SebastianPedroza04/Telemetria-Kart/telemetria-kart/docs/figuras/fig_dinamica.png

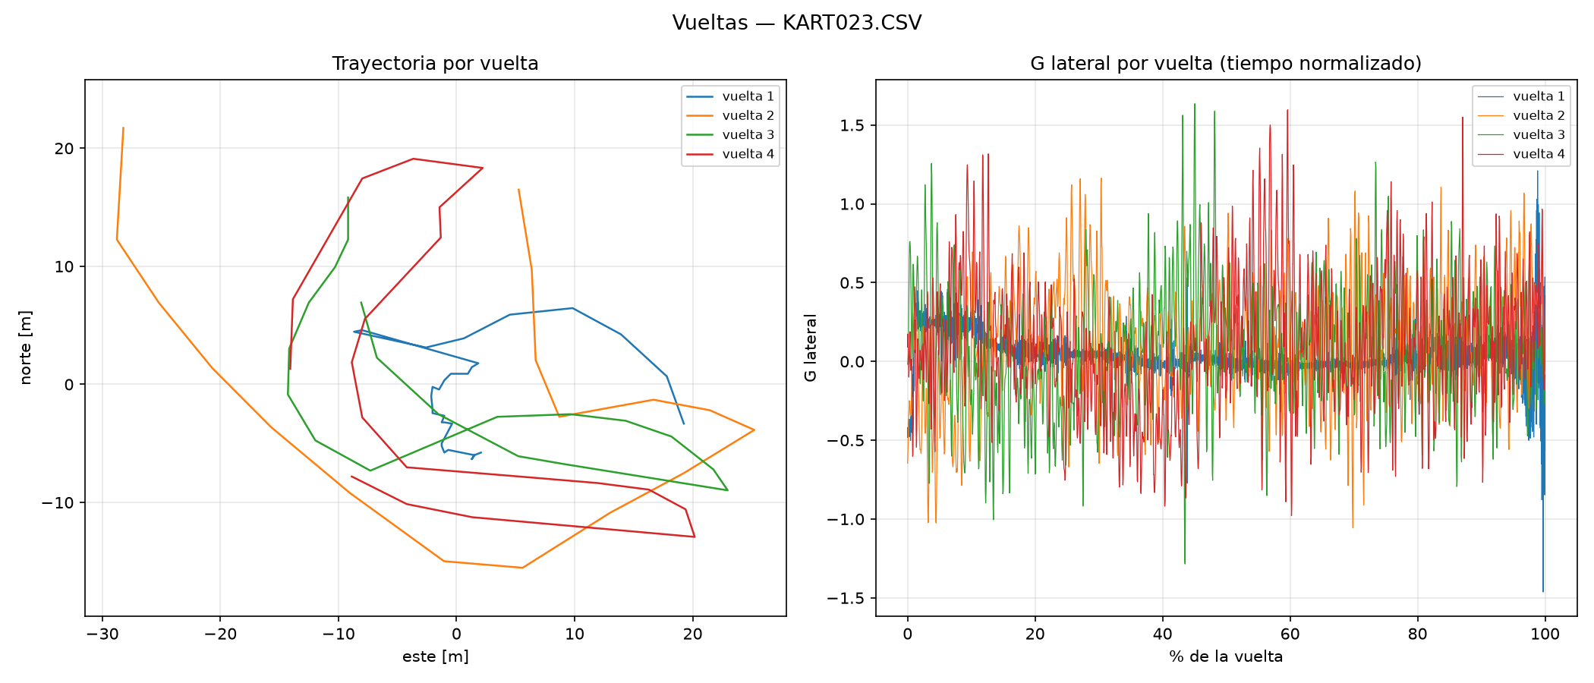
telemetria-kart/docs/figuras/fig_dinamica.png
