SebastianPedroza04/Telemetria-Kart/telemetria-kart/docs/figuras/fig_gg.png

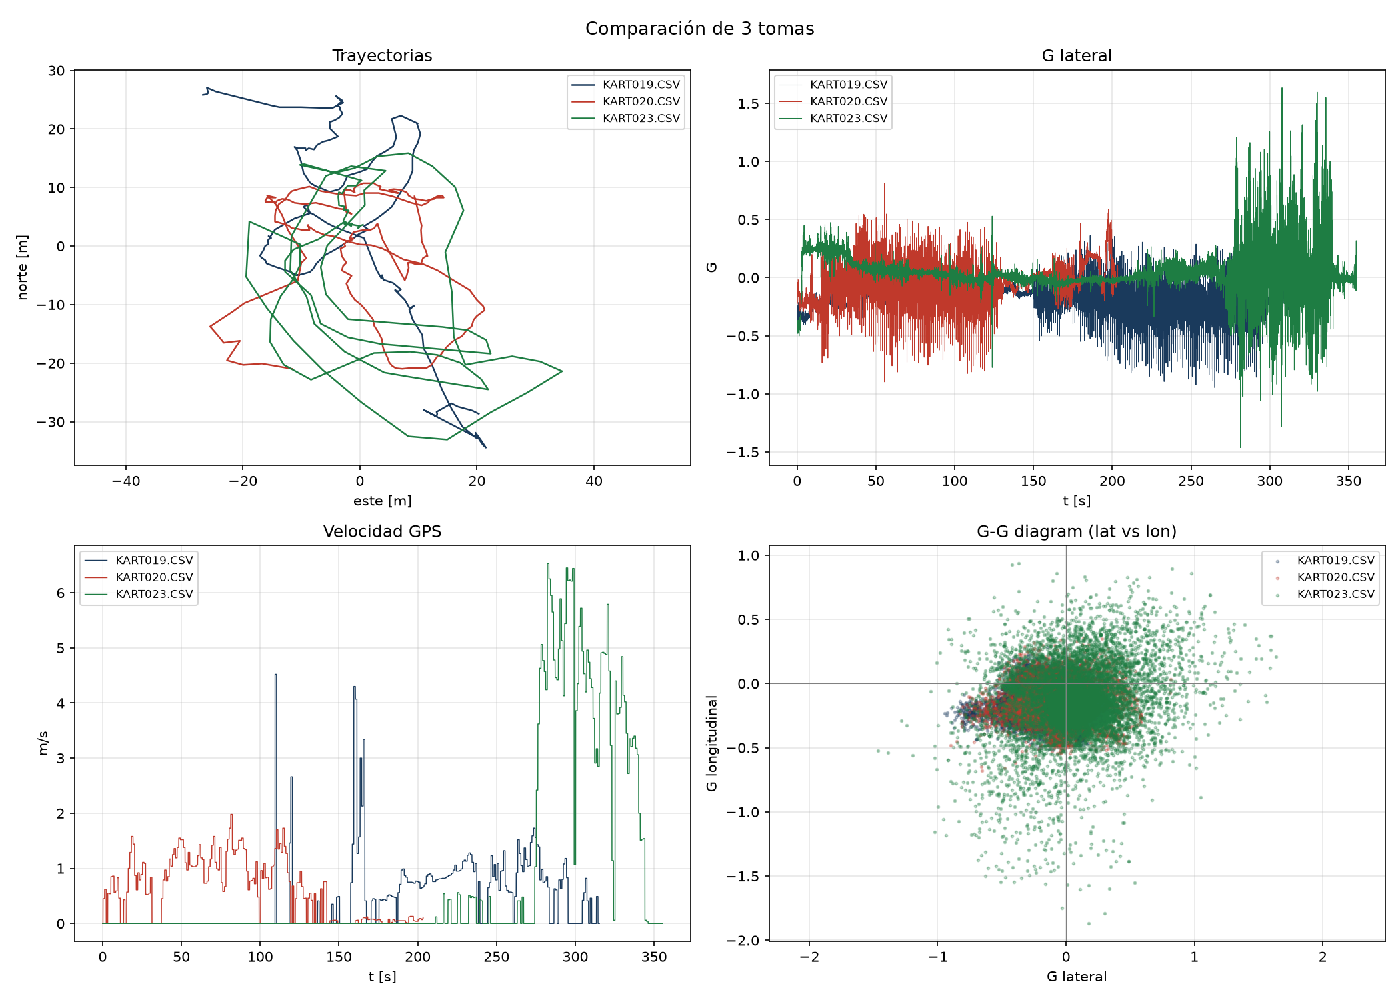
telemetria-kart/docs/figuras/fig_gg.png
