SebastianPedroza04/Telemetria-Kart/telemetria-kart/docs/figuras/fig_sd_lora.png

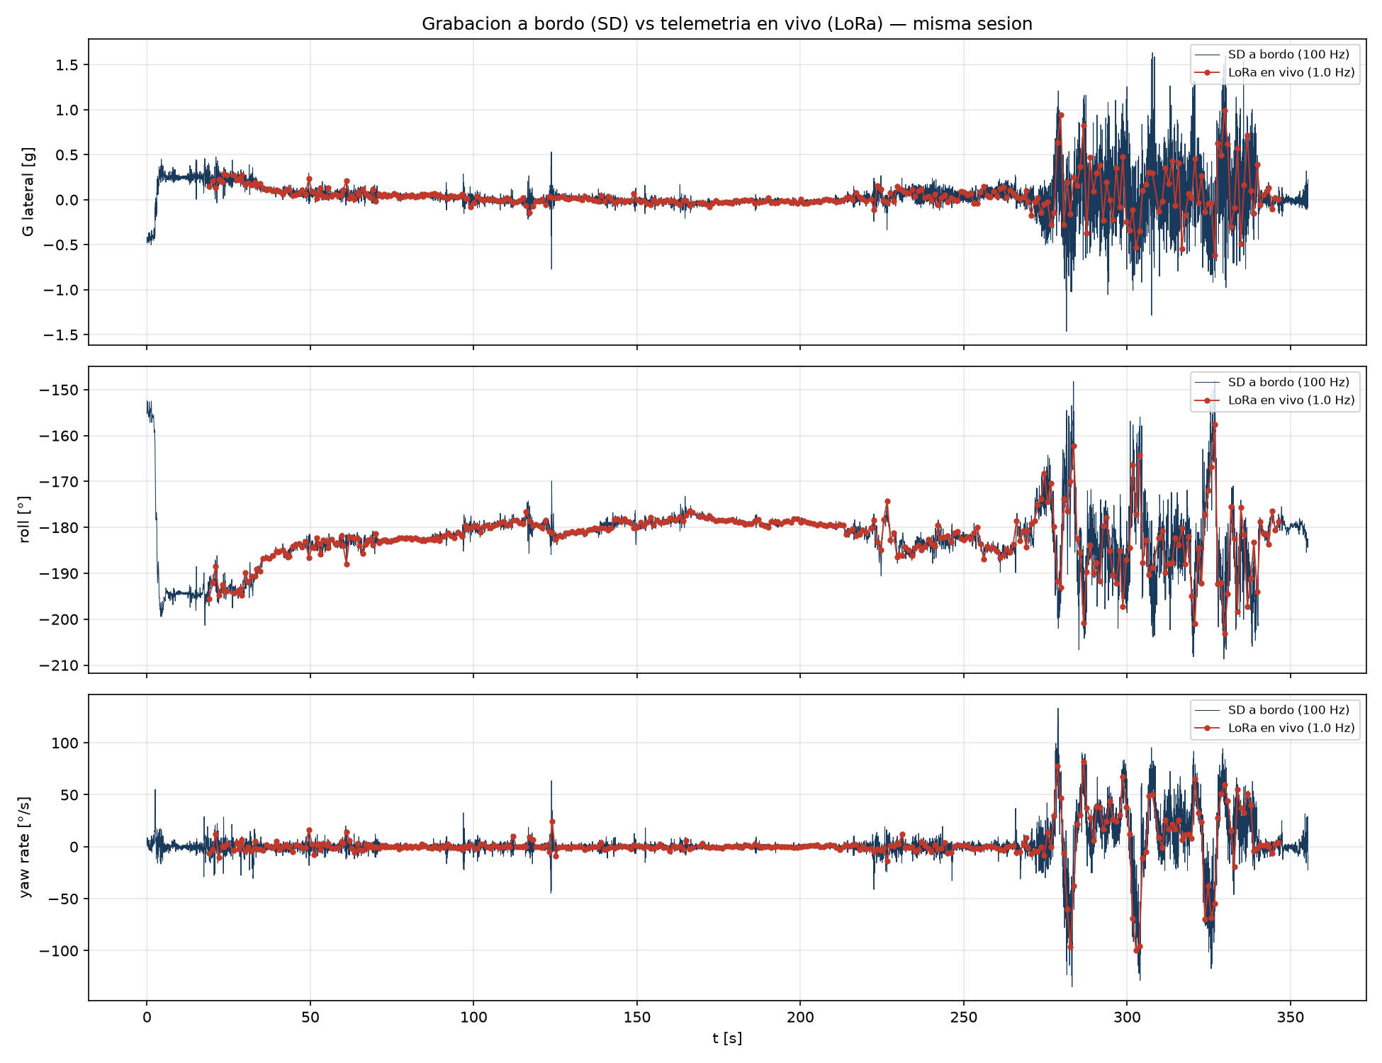
telemetria-kart/docs/figuras/fig_sd_lora.png
