SebastianPedroza04/Telemetria-Kart/telemetria-kart/docs/figuras/fig_trayectoria.png

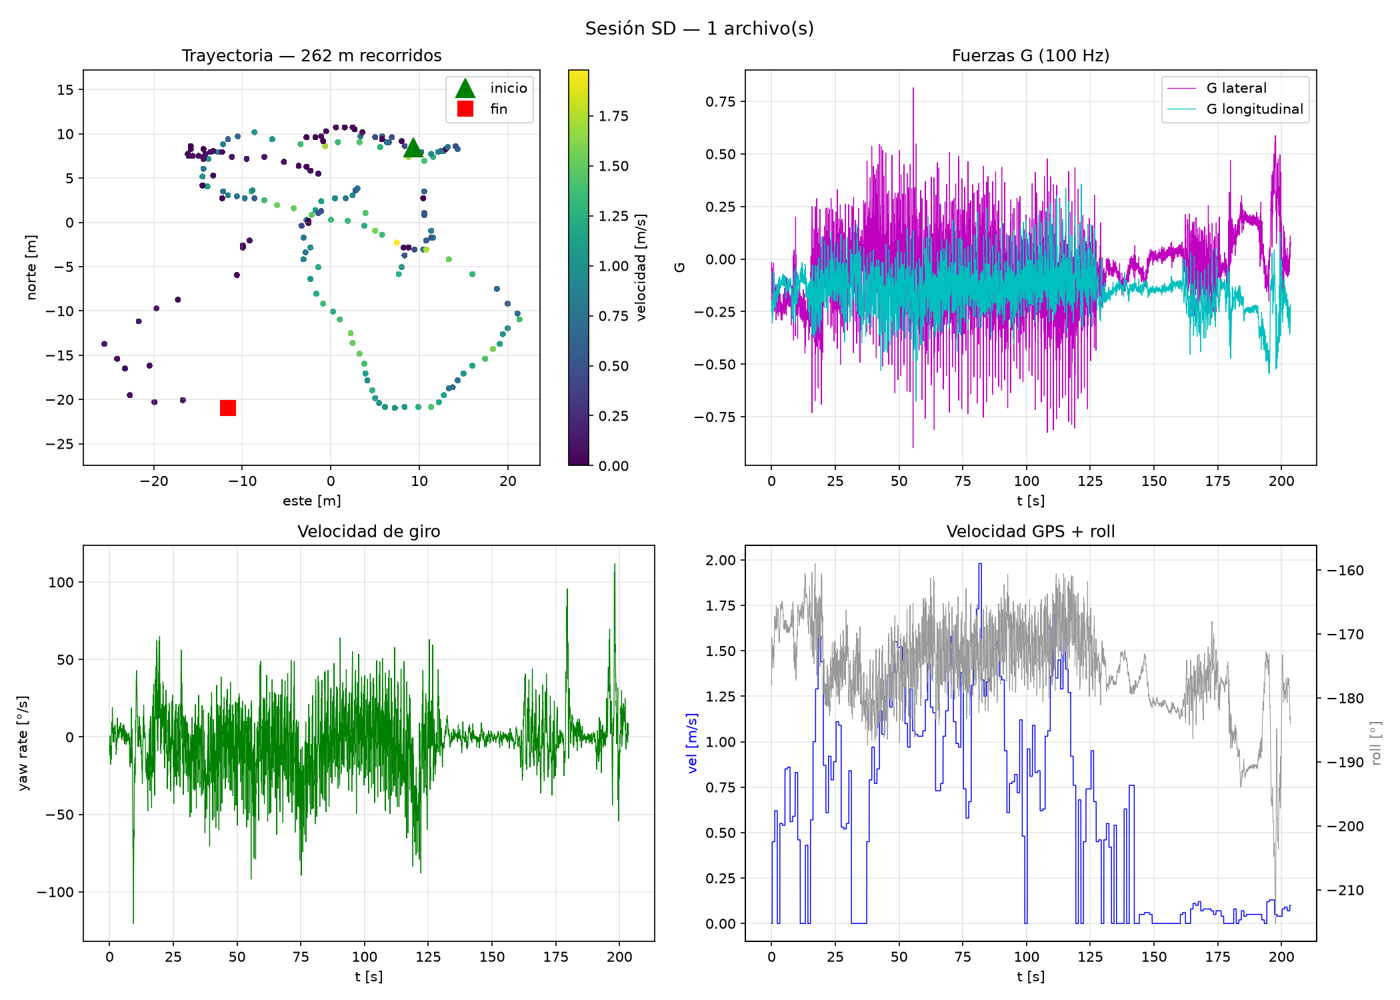
telemetria-kart/docs/figuras/fig_trayectoria.png
