SebastianPedroza04/Telemetria-Kart/telemetria-kart/docs/figuras/KART019_sesion.png

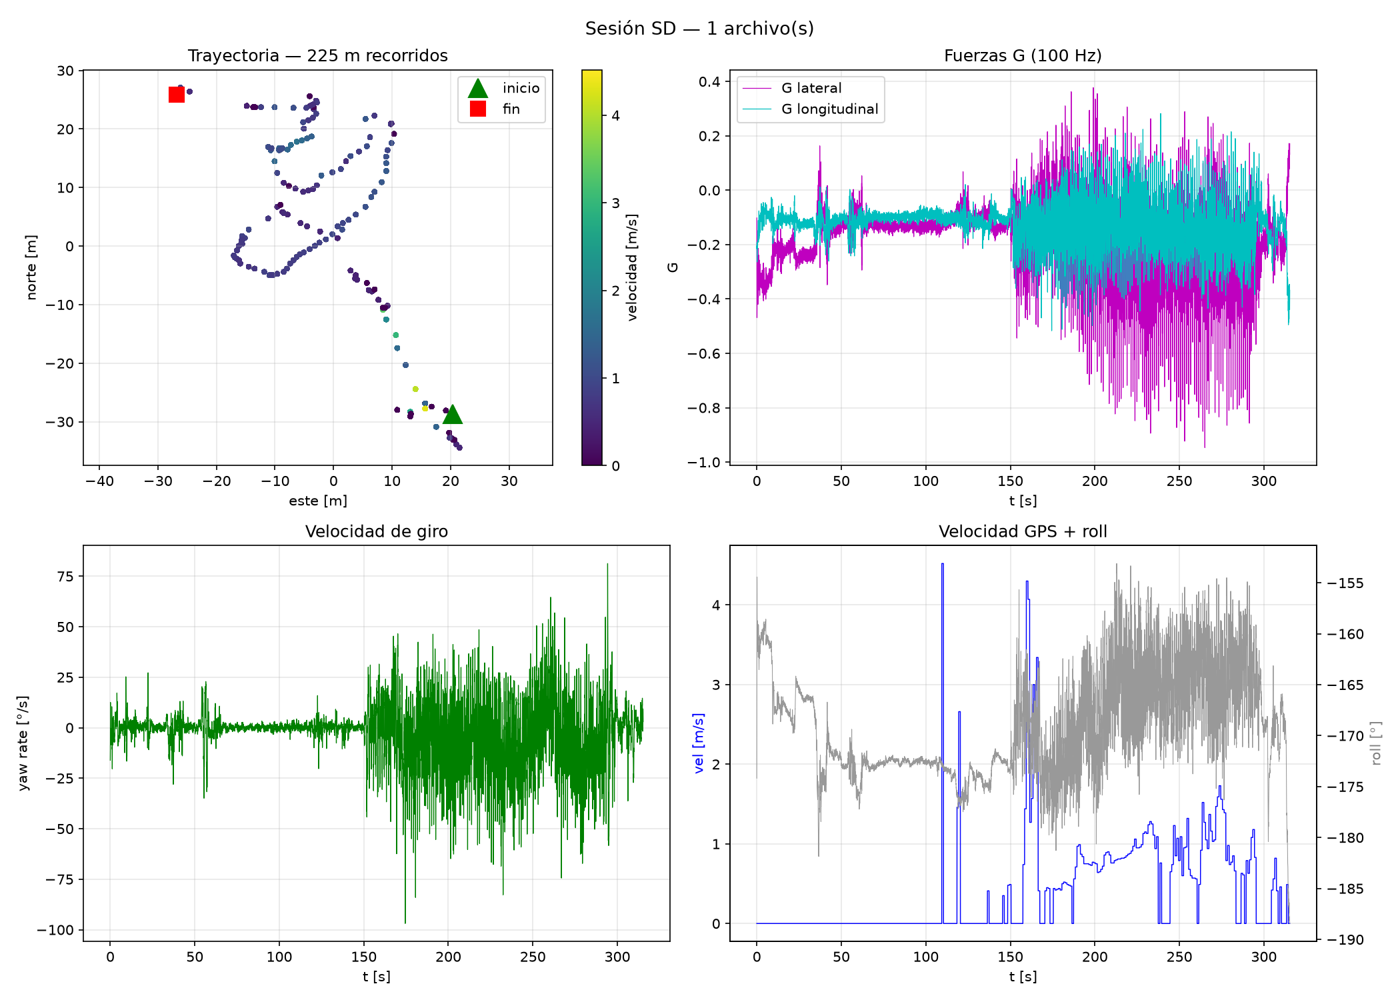
telemetria-kart/docs/figuras/KART019_sesion.png
