SebastianPedroza04/Telemetria-Kart/telemetria-kart/docs/figuras/KART023_sesion.png

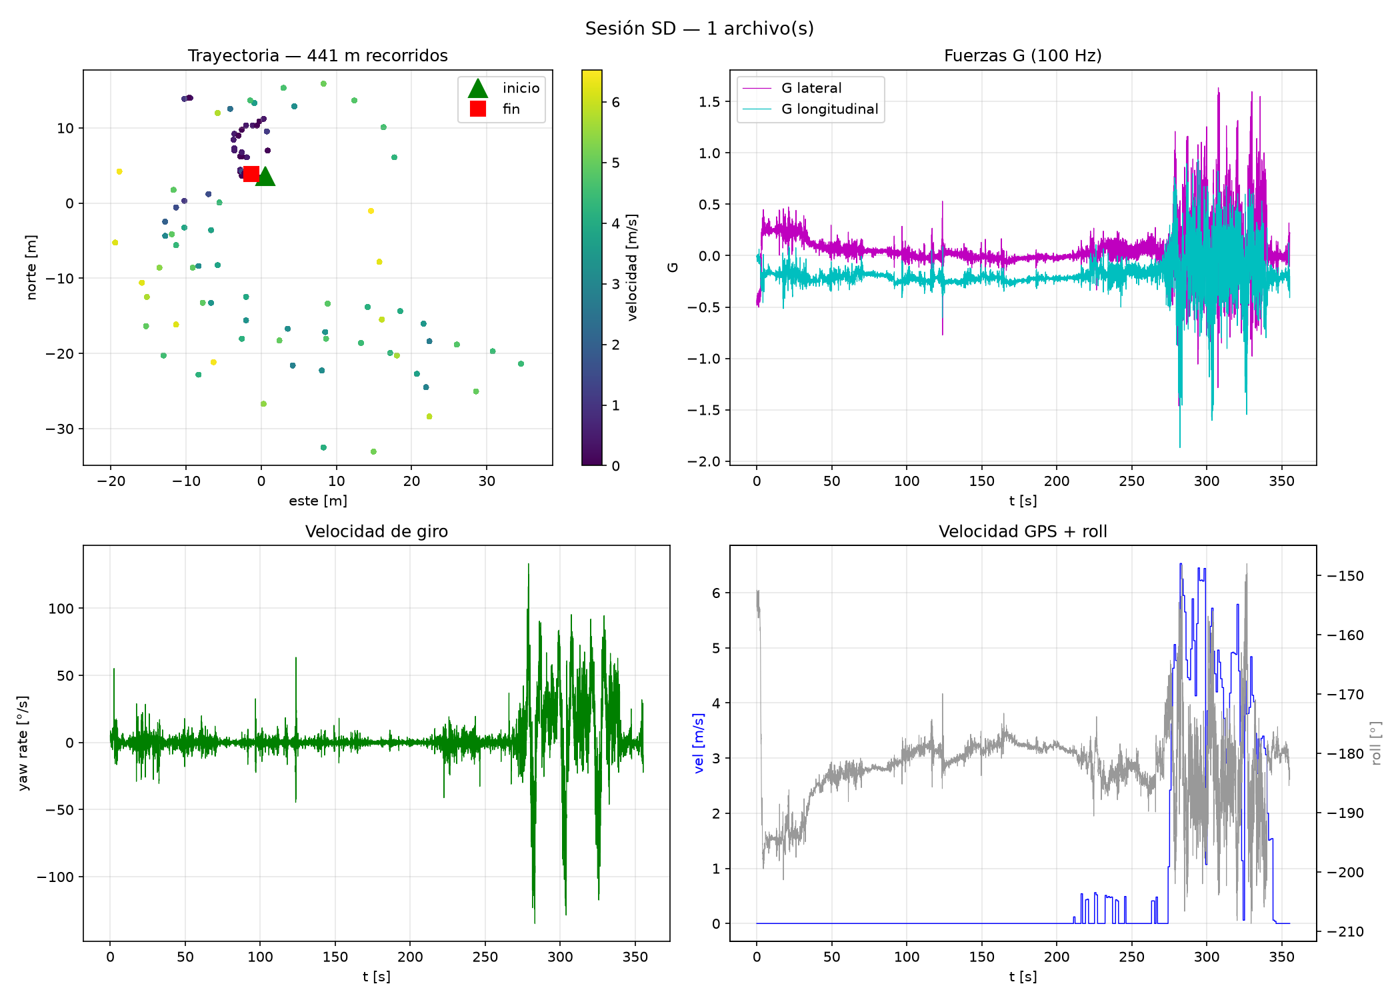
telemetria-kart/docs/figuras/KART023_sesion.png
