SebastianPedroza04/Telemetria-Kart/telemetria-kart/docs/informe/fig_arquitectura.png

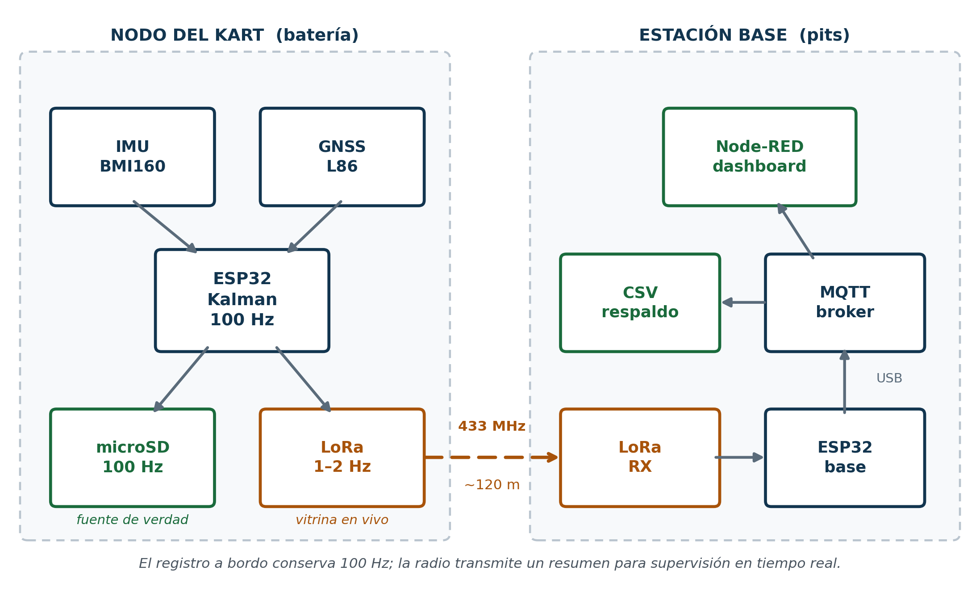
telemetria-kart/docs/informe/fig_arquitectura.png
