SebastianPedroza04/Telemetria-Kart/telemetria-kart/kart_avance_IBM_Loras_GPS/kart/data/deriva_20260717_031146_deriva.png

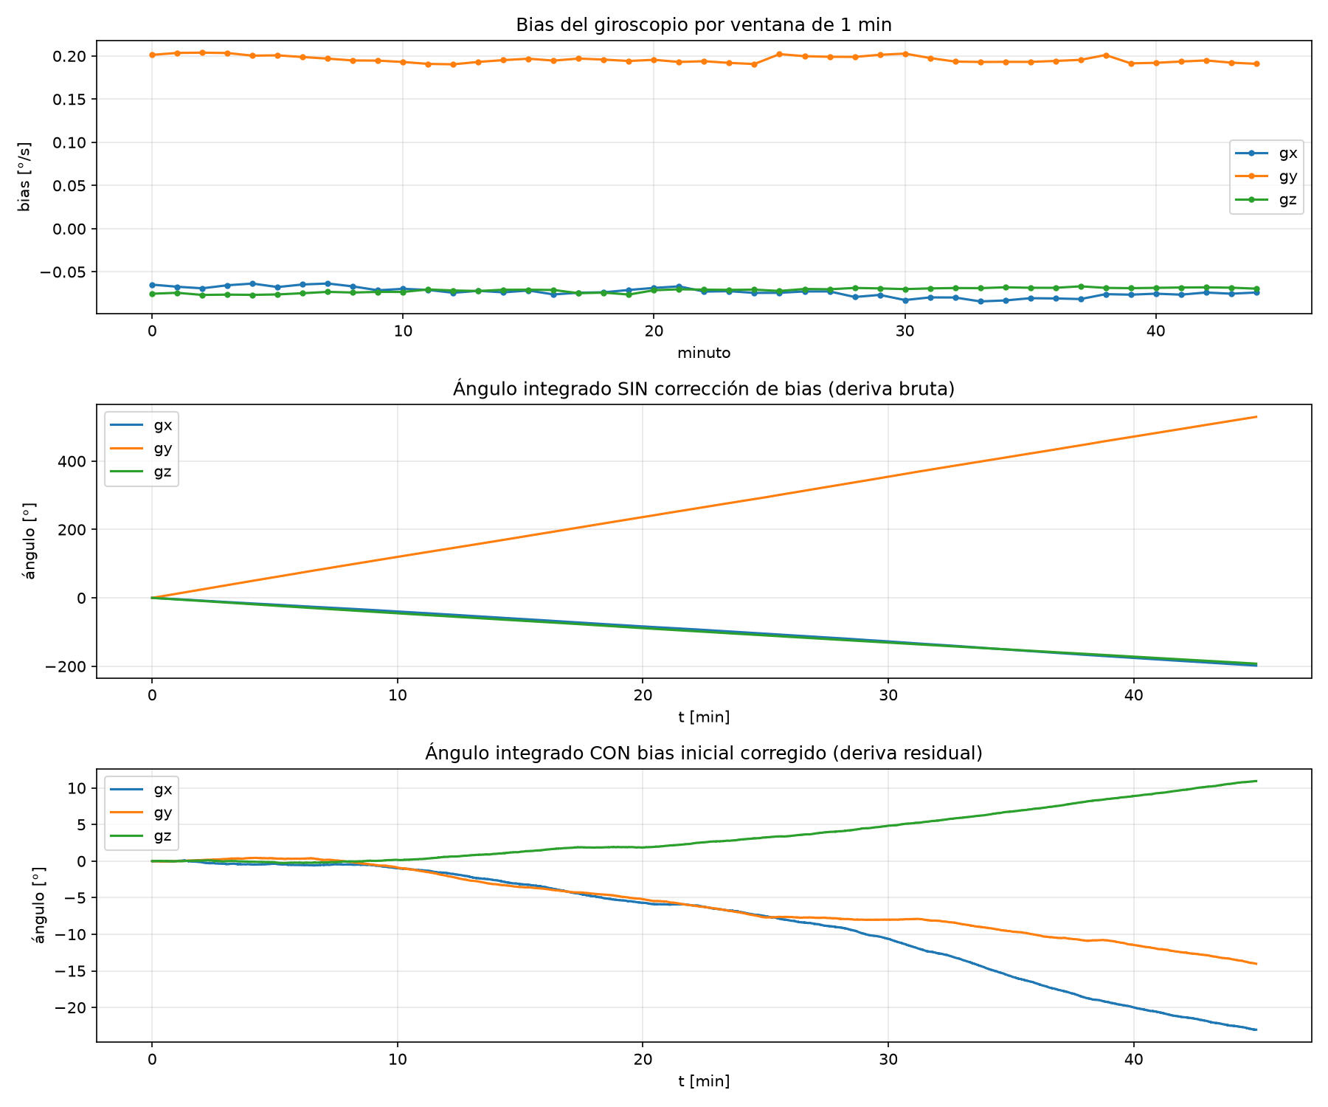
telemetria-kart/kart_avance_IBM_Loras_GPS/kart/data/deriva_20260717_031146_deriva.png
