SebastianPedroza04/Telemetria-Kart/telemetria-kart/kart_avance_IBM_Loras_GPS/kart/data/gps_caminata_20260722_132950_trazada.png

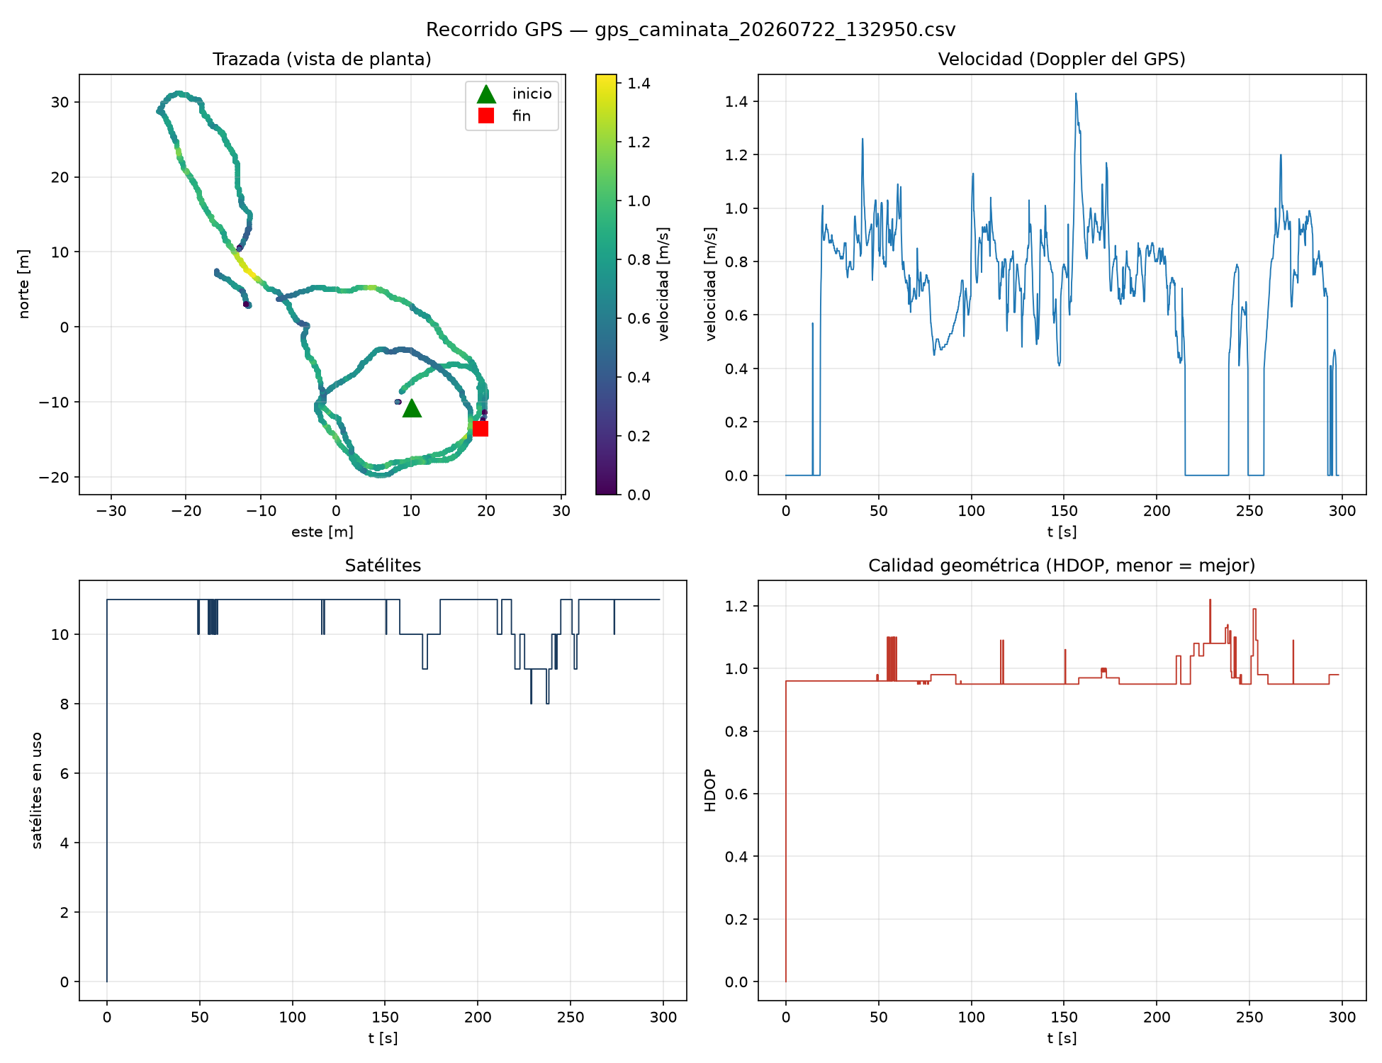
telemetria-kart/kart_avance_IBM_Loras_GPS/kart/data/gps_caminata_20260722_132950_trazada.png
