SebastianPedroza04/Telemetria-Kart/telemetria-kart/kart_avance_IBM_Loras_GPS/kart/data/kfv3_20260717_121305_comparacion.png

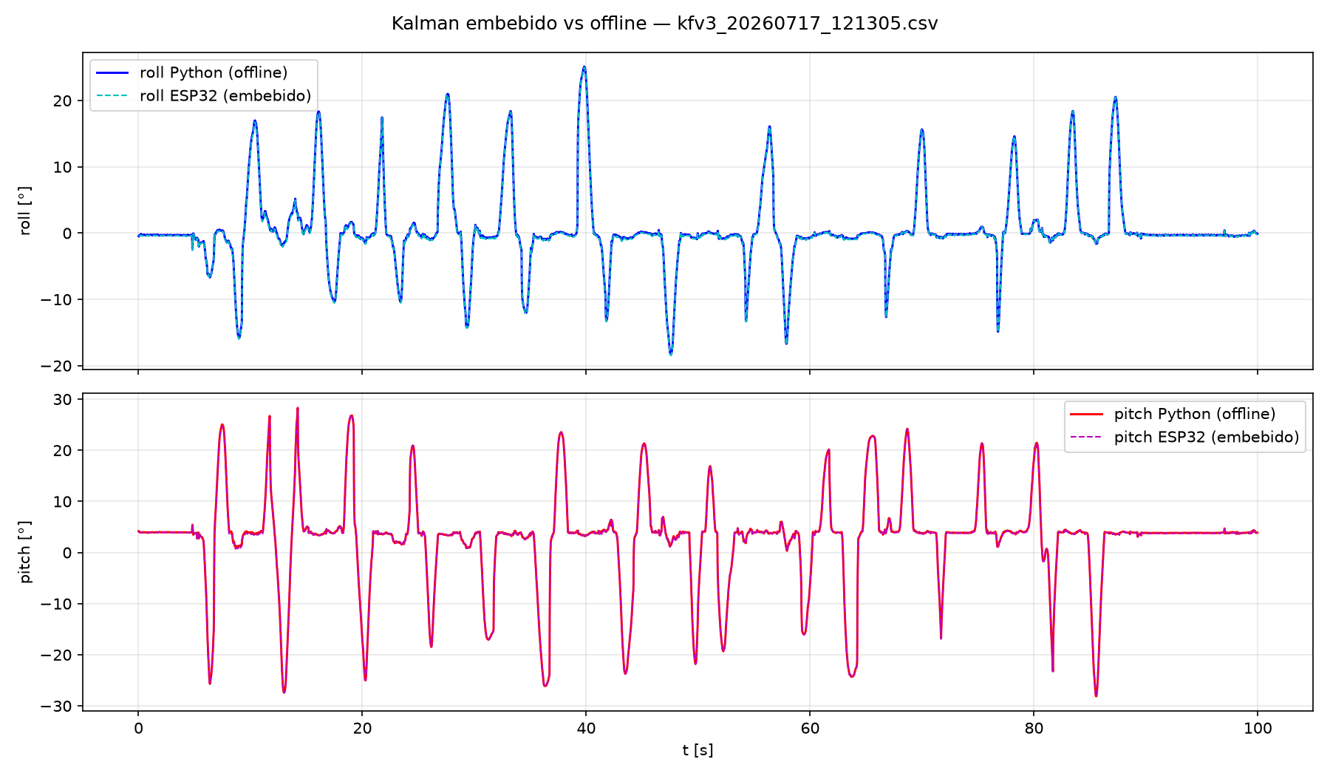
telemetria-kart/kart_avance_IBM_Loras_GPS/kart/data/kfv3_20260717_121305_comparacion.png
