SebastianPedroza04/Telemetria-Kart/telemetria-kart/kart_avance_IBM_Loras_GPS/kart/data/lora/lora_20260721_122409_graficas.png

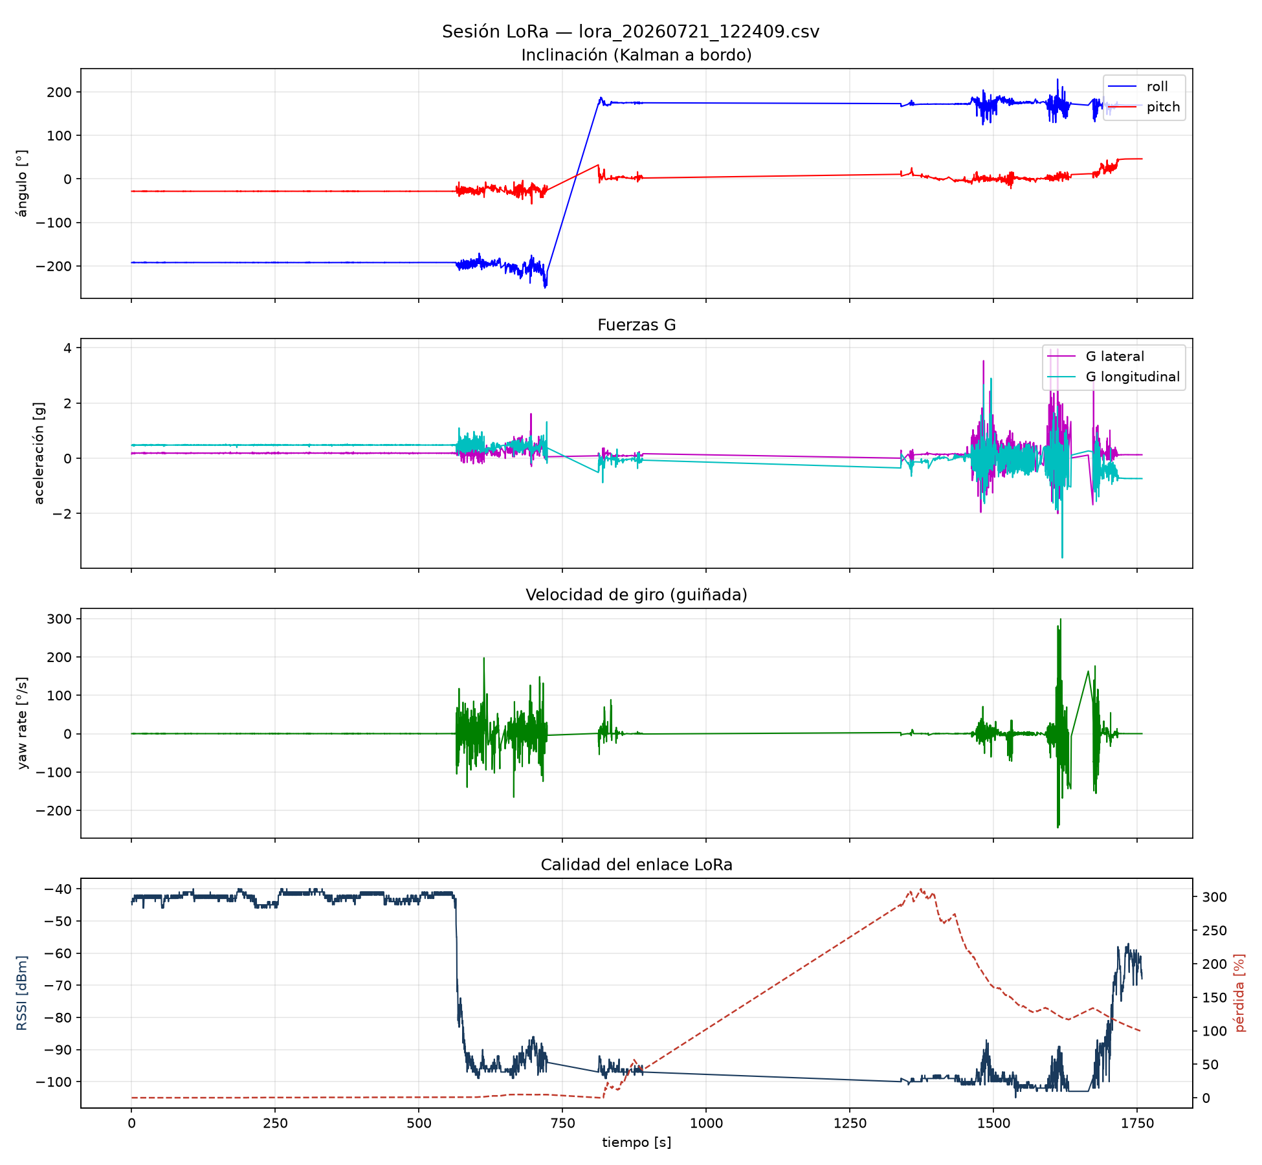
telemetria-kart/kart_avance_IBM_Loras_GPS/kart/data/lora/lora_20260721_122409_graficas.png
