SebastianPedroza04/Telemetria-Kart/telemetria-kart/kart_avance_IBM_Loras_GPS/kart/data/mov_1_20260717_040945_kalman_q1.png

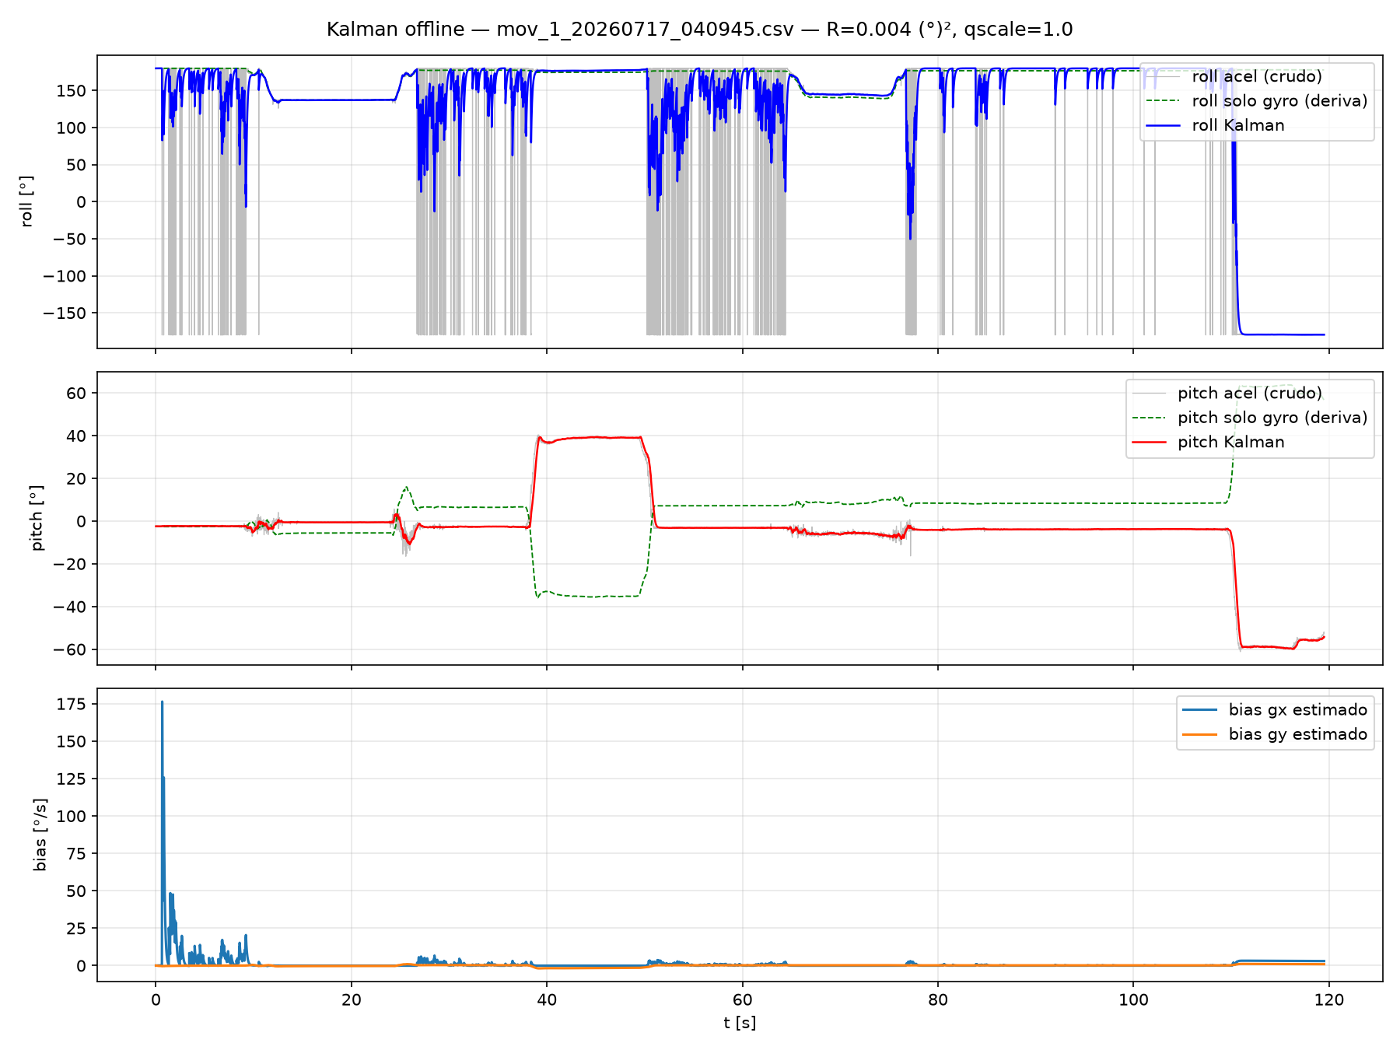
telemetria-kart/kart_avance_IBM_Loras_GPS/kart/data/mov_1_20260717_040945_kalman_q1.png
