SebastianPedroza04/Telemetria-Kart/telemetria-kart/kart_avance_IBM_Loras_GPS/kart/data/mov_2_20260717_041805_kalman_q0.1.png

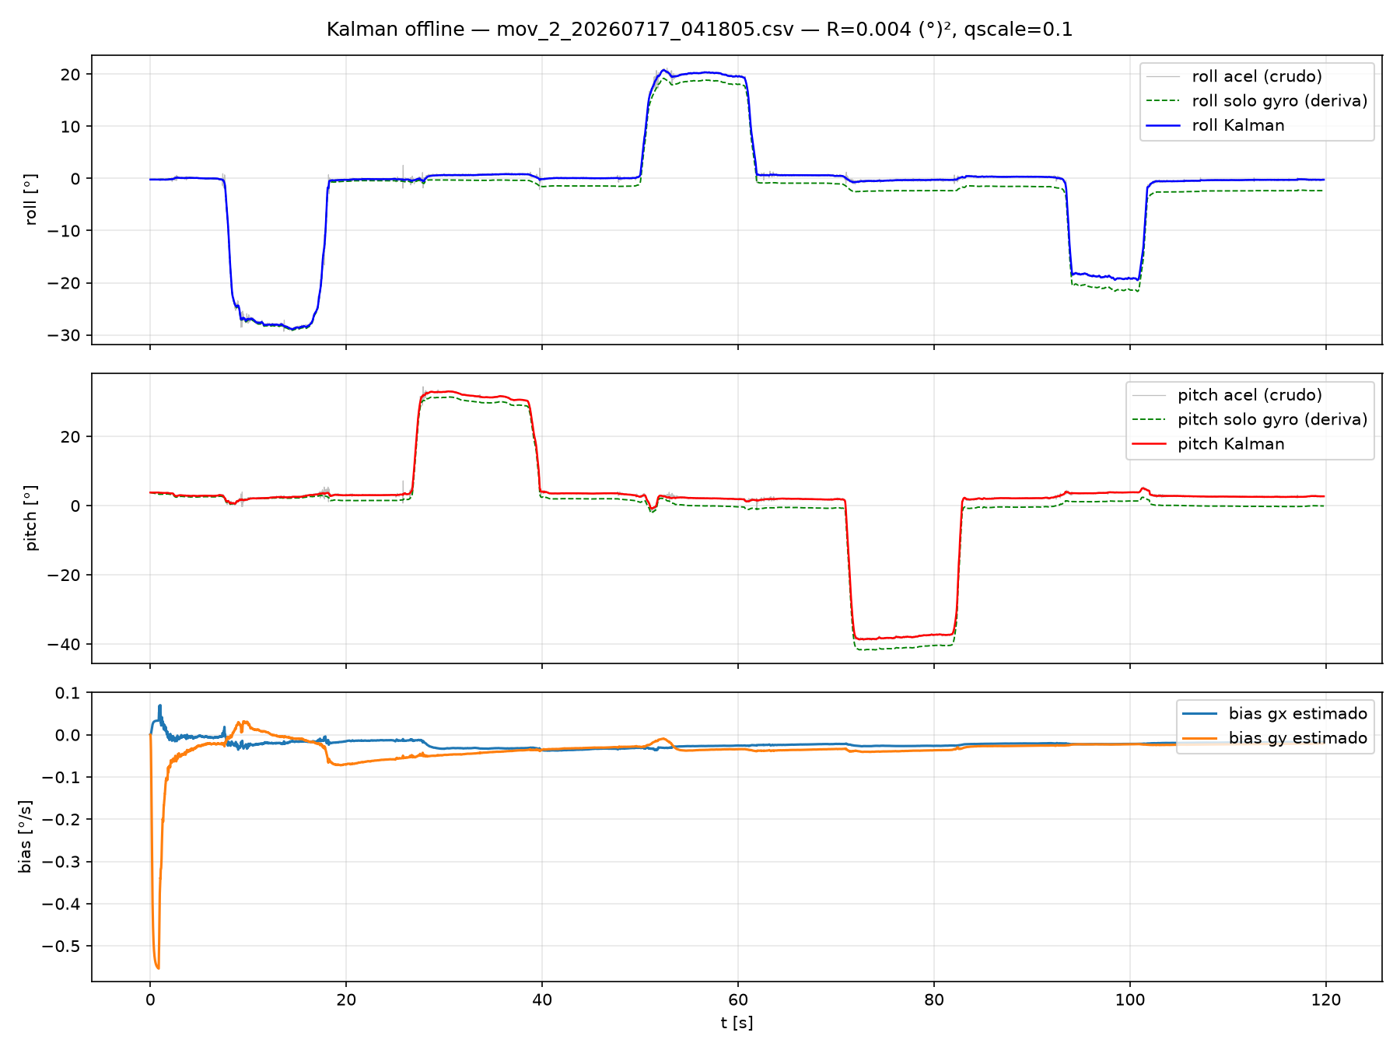
telemetria-kart/kart_avance_IBM_Loras_GPS/kart/data/mov_2_20260717_041805_kalman_q0.1.png
