SebastianPedroza04/Telemetria-Kart/telemetria-kart/kart_avance_IBM_Loras_GPS/kart/data/reposo_bmi160_20260714_125733_reposo.png

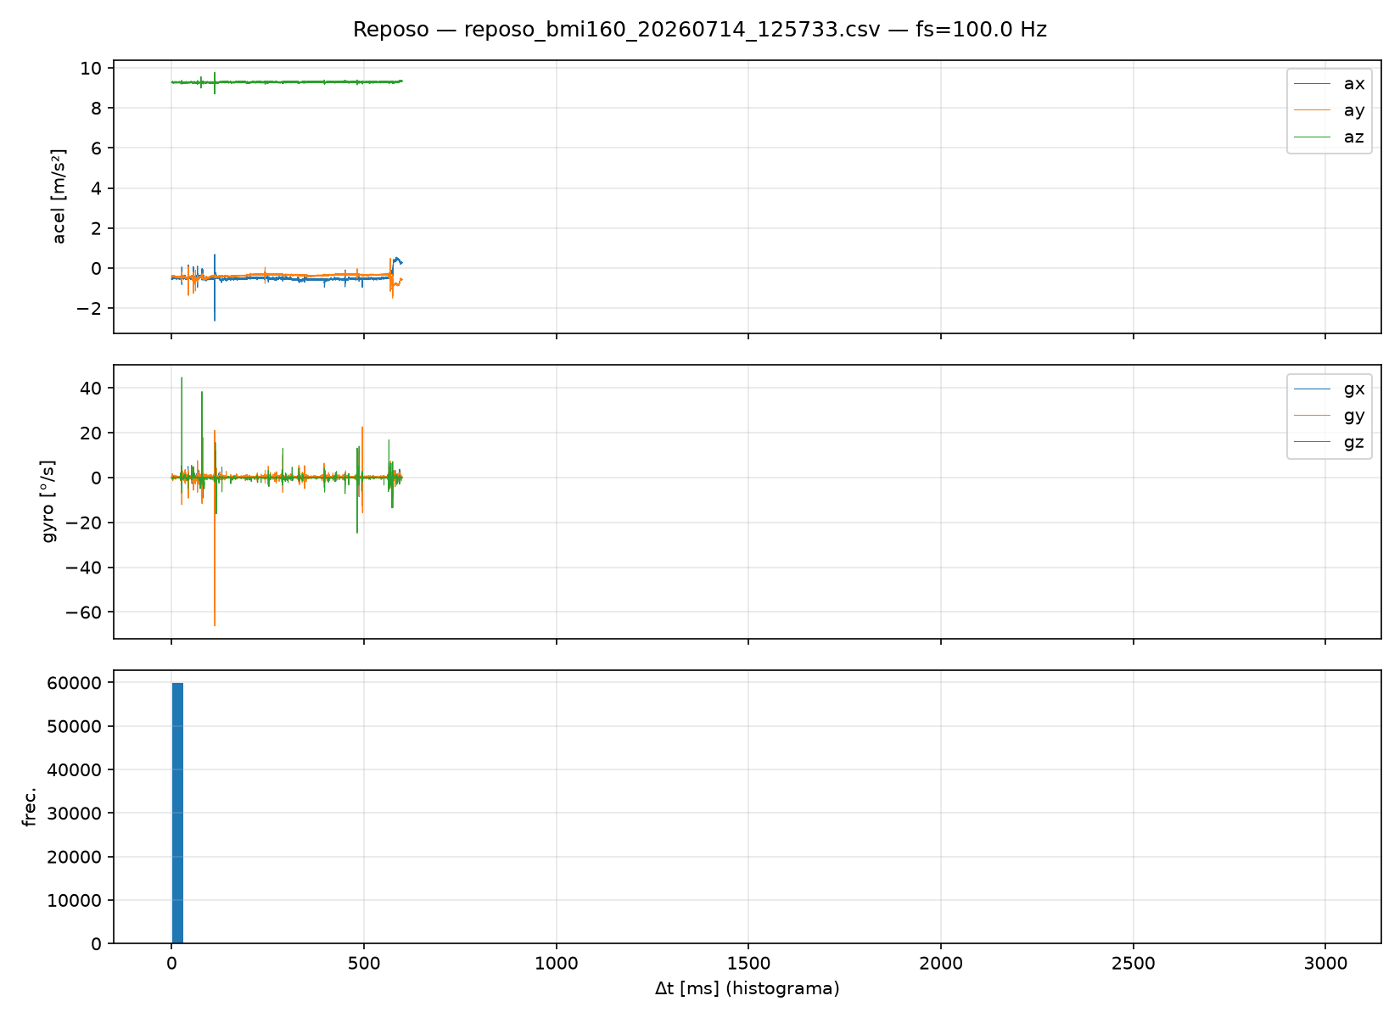
telemetria-kart/kart_avance_IBM_Loras_GPS/kart/data/reposo_bmi160_20260714_125733_reposo.png
