SebastianPedroza04/Telemetria-Kart/telemetria-kart/kart_avance_IBM_Loras_GPS/kart/data/reposo_v2_20260714_131845_reposo.png

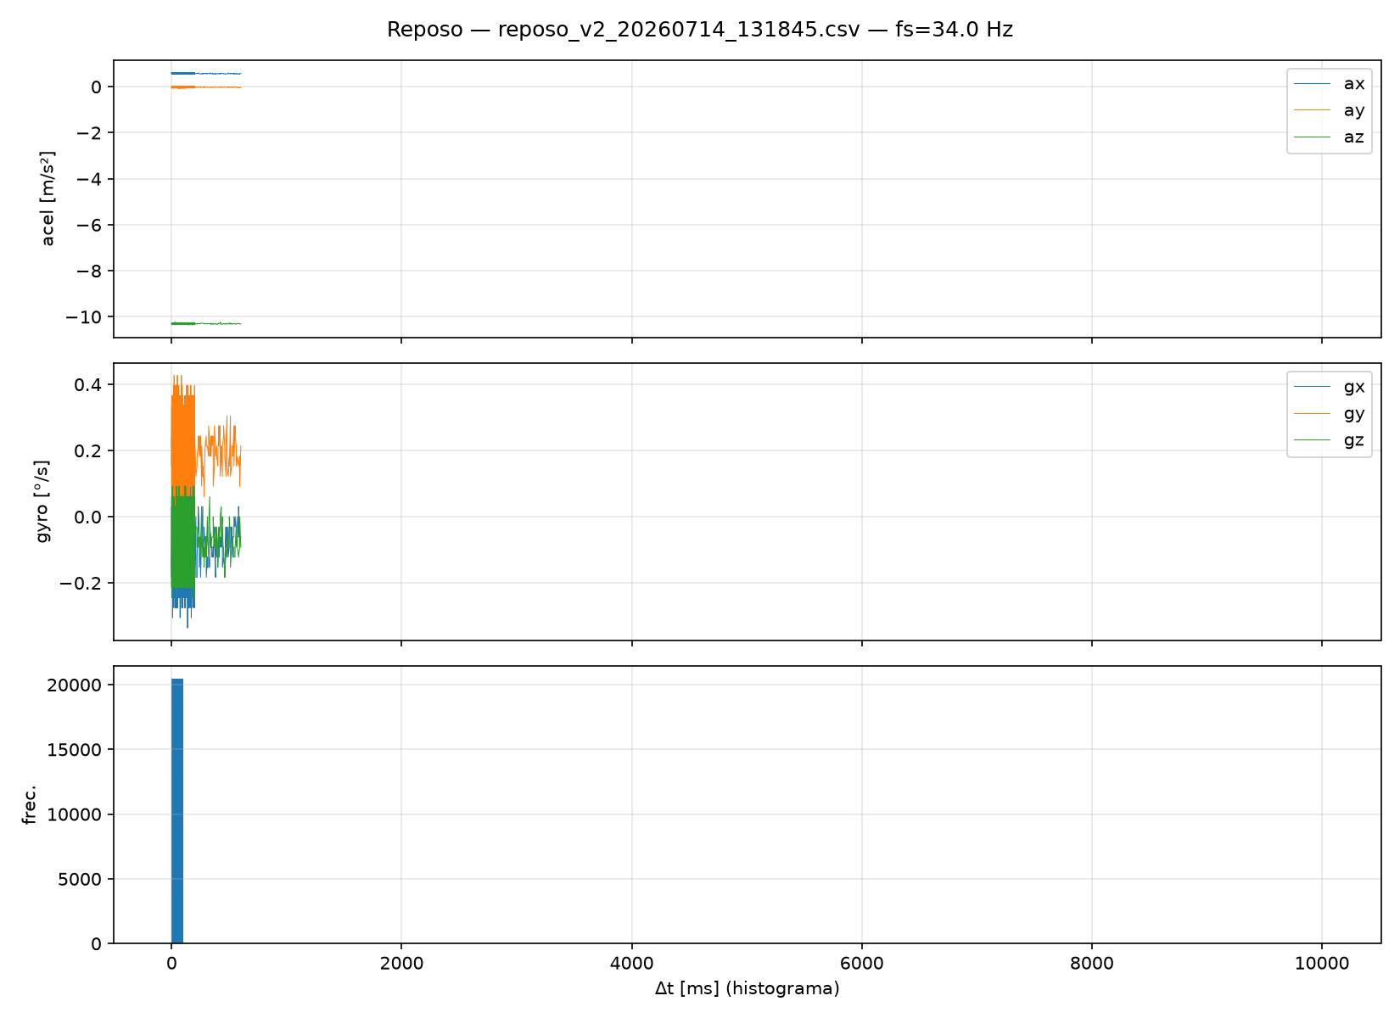
telemetria-kart/kart_avance_IBM_Loras_GPS/kart/data/reposo_v2_20260714_131845_reposo.png
