SebastianPedroza04/Telemetria-Kart/telemetria-kart/kart_avance_IBM_Loras_GPS/kart/data/reposo_v4_20260717_022110_kalman_q1.png

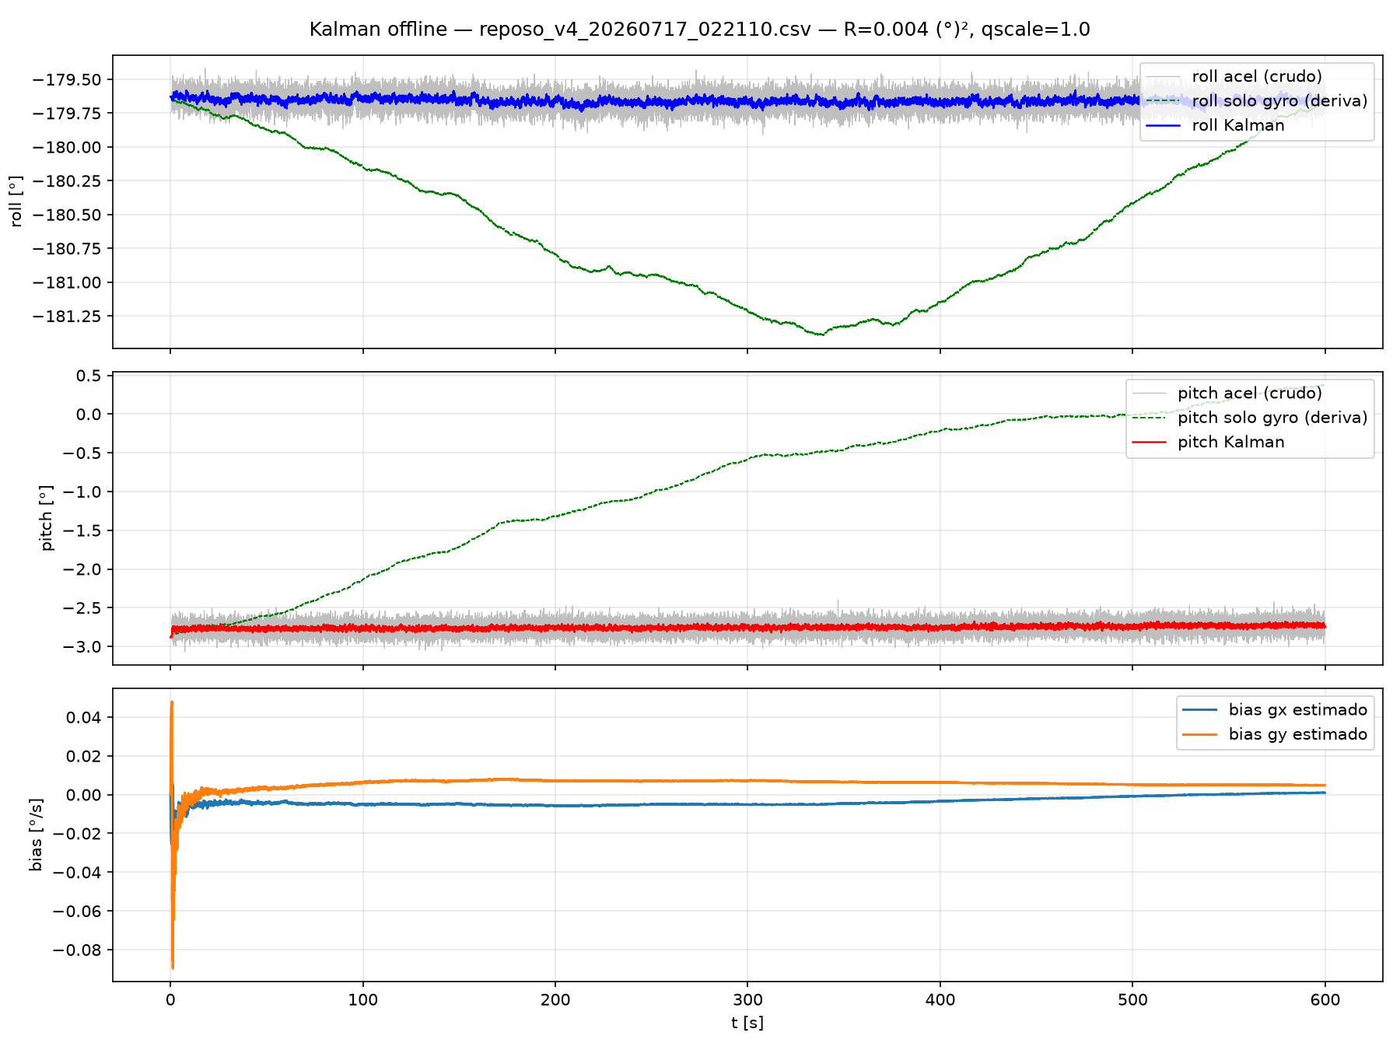
telemetria-kart/kart_avance_IBM_Loras_GPS/kart/data/reposo_v4_20260717_022110_kalman_q1.png
