SebastianPedroza04/Telemetria-Kart/telemetria-kart/kart_avance_IBM_Loras_GPS/kart/data/tortura_20260717_123312_comparacion.png

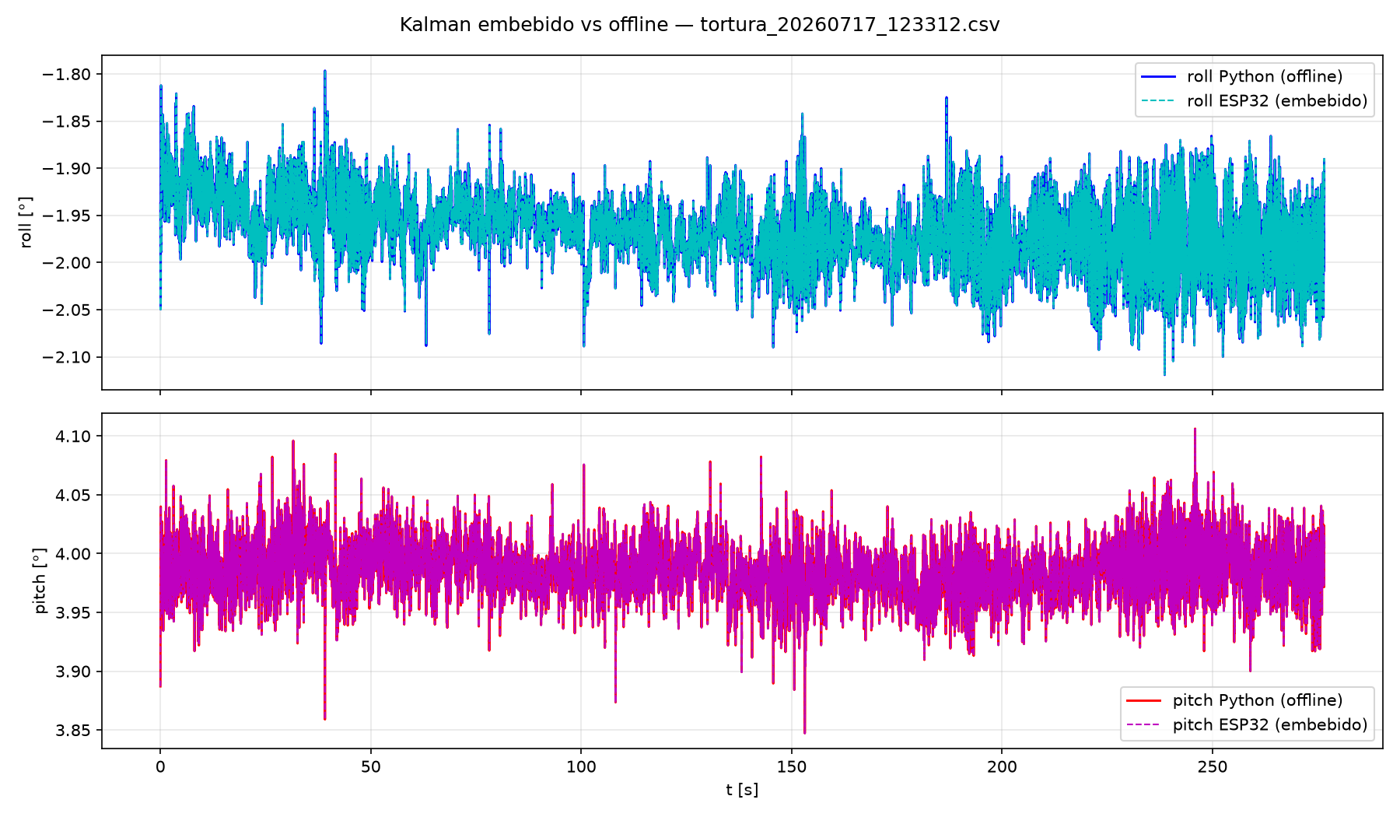
telemetria-kart/kart_avance_IBM_Loras_GPS/kart/data/tortura_20260717_123312_comparacion.png
