SebastianPedroza04/Telemetria-Kart/telemetria-kart/kart_avance_IBM_Loras_GPS/kart/data/vibracion_psd.png

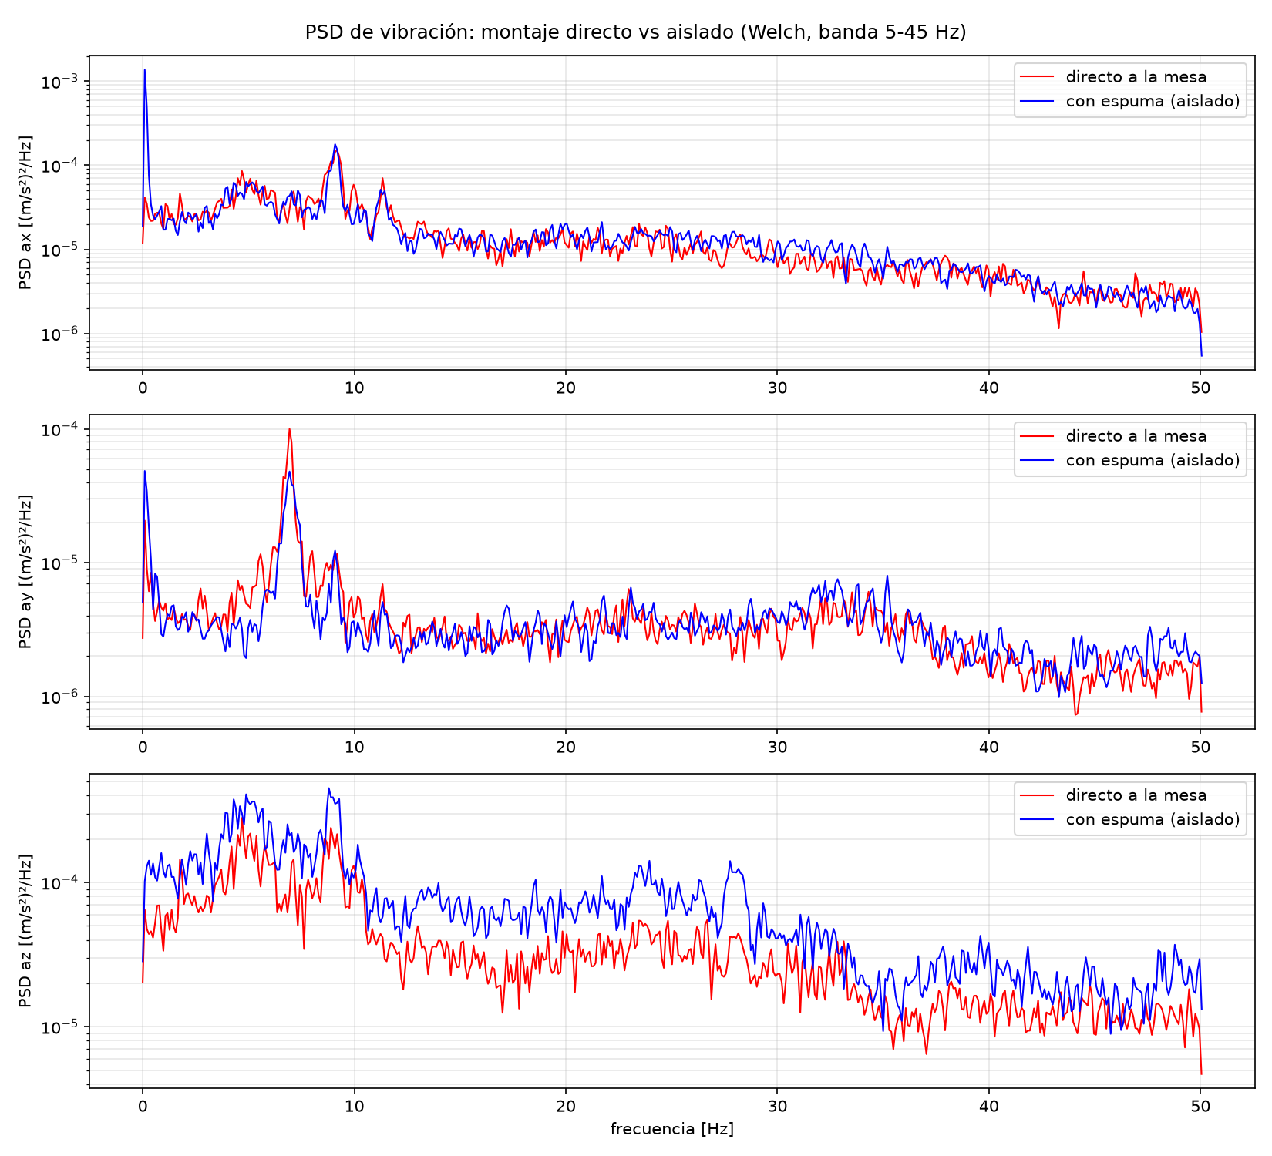
telemetria-kart/kart_avance_IBM_Loras_GPS/kart/data/vibracion_psd.png
