SebastianPedroza04/Telemetria-Kart/(commit log)

2026-07-21 Add files via upload
    Primer avance documentado del sistema de telemetría
2026-07-23 adiccion de platformio
2026-07-23 añado carpeta con gps
    [deriva_20260717_031146_deriva.csv, gps_caminata_20260722_132950.csv, kfv3_20260717_121305.csv, lora_20260721_120713.csv, lora_20260721_120750.csv, lora_20260721_122409.csv, mov_1_20260717_040945.csv, mov_2_20260717_041805.csv]
2026-07-24 Actualizar documentación y scripts finales
    Se reorganiza el proyecto, se actualiza README, se agregan scripts de análisis y se documenta el flujo final con Node-RED y Python.
    [deriva_20260717_031146_deriva.csv, gps_caminata_20260722_132950.csv, kfv3_20260717_121305.csv, lora_20260721_120713.csv, lora_20260721_120750.csv, lora_20260721_122409.csv, mov_1_20260717_040945.csv, mov_2_20260717_041805.csv]
2026-07-24 jason para linux
2026-07-29 Campana de campo 24/07: datos SD y LoRa, scripts de analisis, informe IEEE y README actualizado
    [KART017.CSV, KART018.CSV, KART019.CSV, KART020.CSV, KART021.CSV, KART023.CSV, KART024.CSV, lora_20260724_162058.csv]
2026-07-31 Velocidad fusionada y distancia: puente MQTT v2, analisis desde microSD y README actualizado
